MERL-Rose-Hulman/LilyBot-Raspberry-Pi/README.md

# LilyBot-Raspberry-Pi
LilyBot-Raspberry-Pi is a dedicated repository for the Raspberry Pi version of the Lilybot project. This repository includes specific code, 3D printed parts, electronic schematics, and detailed assembly instructions tailored for the Raspberry Pi controller.

use 3.3V sonar mounts for Grove system

gonna use grove system for wire connections, make the things easier.

Resberry pi OS will be use and all software will be installed from there as a package we can providiede.
