MERL-Rose-Hulman/LilyBot-Raspberry-Pi/3d_print_parts/Battery Mount/solidworks/Power Bank Holder.SLDPRT

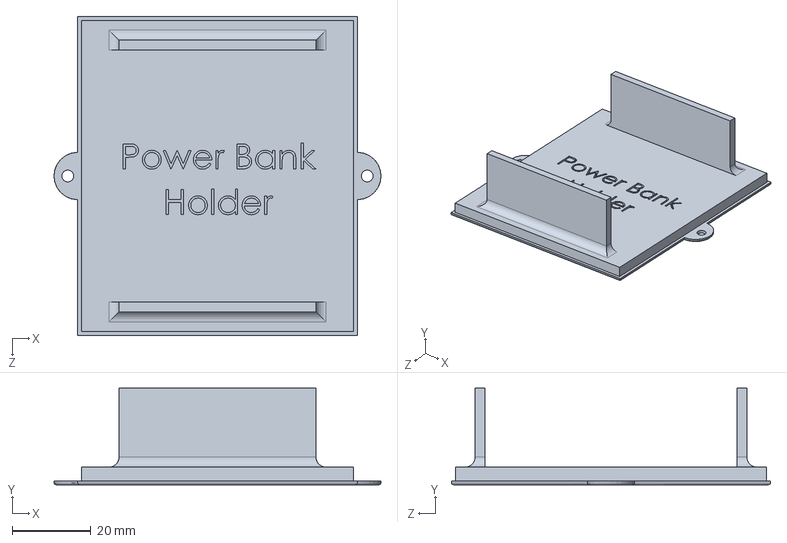
[picture p1: CAD file, 2024-08-13]
3d_print_parts/Battery Mount/solidworks/Power Bank Holder.SLDPRT
83.0 x 24.5 x 81.0 mm
