MERL-Rose-Hulman/LilyBot-Raspberry-Pi/3d_print_parts/Controller Mount/printer/Raspberry Pi_Module.3mf

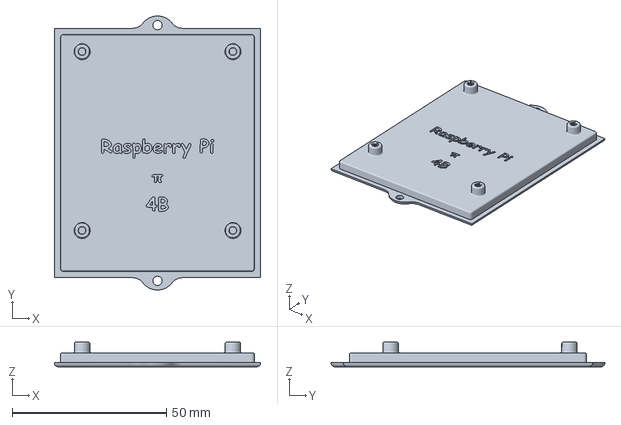
[picture p2: CAD file, 2025-09-22]
3d_print_parts/Controller Mount/printer/Raspberry Pi_Module.3mf
66.9 x 88.9 x 8.07 mm
