MERL-Rose-Hulman/LilyBot-Raspberry-Pi/LilyBotCommon/3D Print Parts/actuator/gripper/solidworks/Gripper attachment.SLDPRT

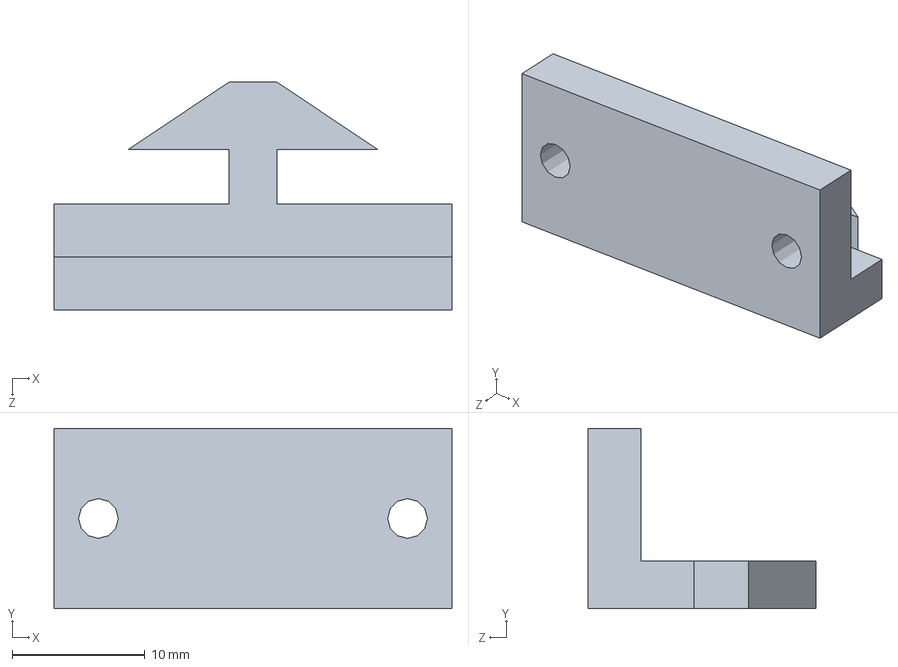
[picture p3: CAD file, 2024-08-06]
LilyBotCommon/3D Print Parts/actuator/gripper/solidworks/Gripper attachment.SLDPRT
30.0 x 13.6 x 17.2 mm
