MERL-Rose-Hulman/LilyBot-Raspberry-Pi/LilyBotCommon/3D Print Parts/actuator/gripper/stl/top-plate-fixed.stl

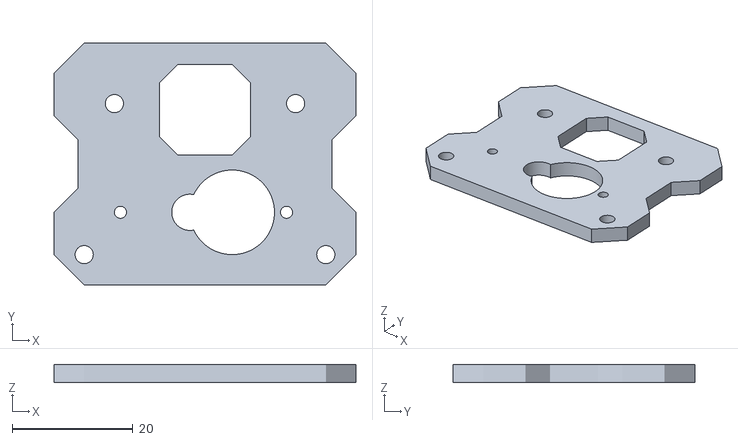
[picture p4: CAD file, 2024-08-06]
LilyBotCommon/3D Print Parts/actuator/gripper/stl/top-plate-fixed.stl
50.0 x 40.0 x 3.00
