MERL-Rose-Hulman/LilyBot-Raspberry-Pi/LilyBotCommon/3D Print Parts/chassis/bottom/solidworks/Lily Bottom Snap.SLDPRT

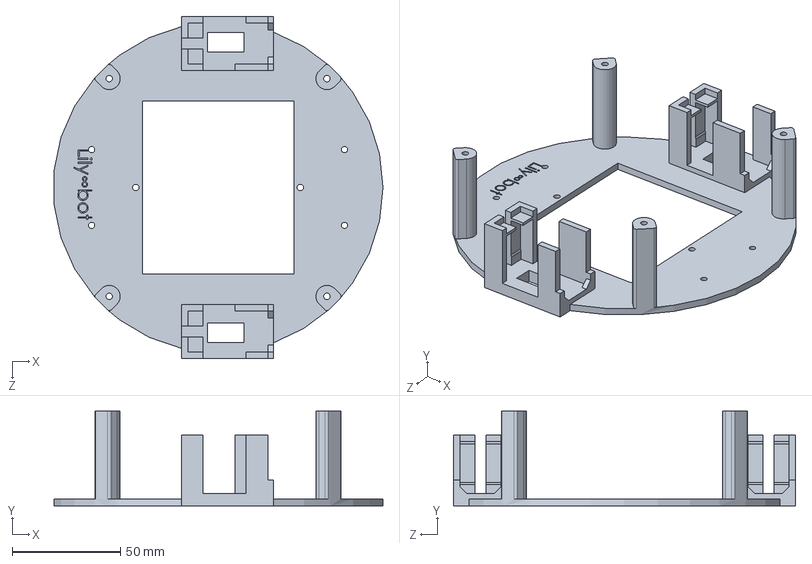
[picture p5: CAD file, 2024-08-06]
LilyBotCommon/3D Print Parts/chassis/bottom/solidworks/Lily Bottom Snap.SLDPRT
152.0 x 43.8 x 158.0 mm
