MERL-Rose-Hulman/LilyBot-Raspberry-Pi/LilyBotCommon/3D Print Parts/chassis/NOLONGERUSE/connection/solidworks/Lily standoffs.SLDPRT

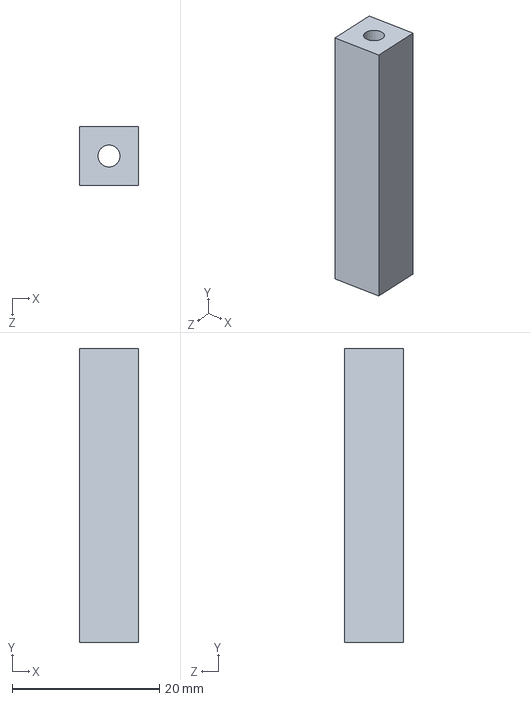
[picture p6: CAD file, 2024-08-06]
LilyBotCommon/3D Print Parts/chassis/NOLONGERUSE/connection/solidworks/Lily standoffs.SLDPRT
8.00 x 40.0 x 8.00 mm
