MERL-Rose-Hulman/LilyBot-Raspberry-Pi/LilyBotCommon/3D Print Parts/chassis/top/solidworks/Lily top Flex.SLDPRT

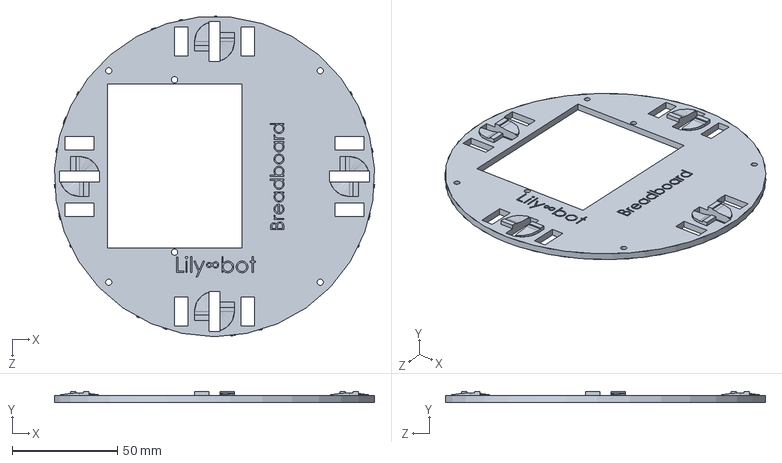
[picture p7: CAD file, 2024-08-06]
LilyBotCommon/3D Print Parts/chassis/top/solidworks/Lily top Flex.SLDPRT
152.2 x 5.08 x 152.4 mm
