MERL-Rose-Hulman/LilyBot-Raspberry-Pi/LilyBotCommon/3D Print Parts/cover/cover-higher-hight/solidworks/Lily Cover v2.SLDPRT

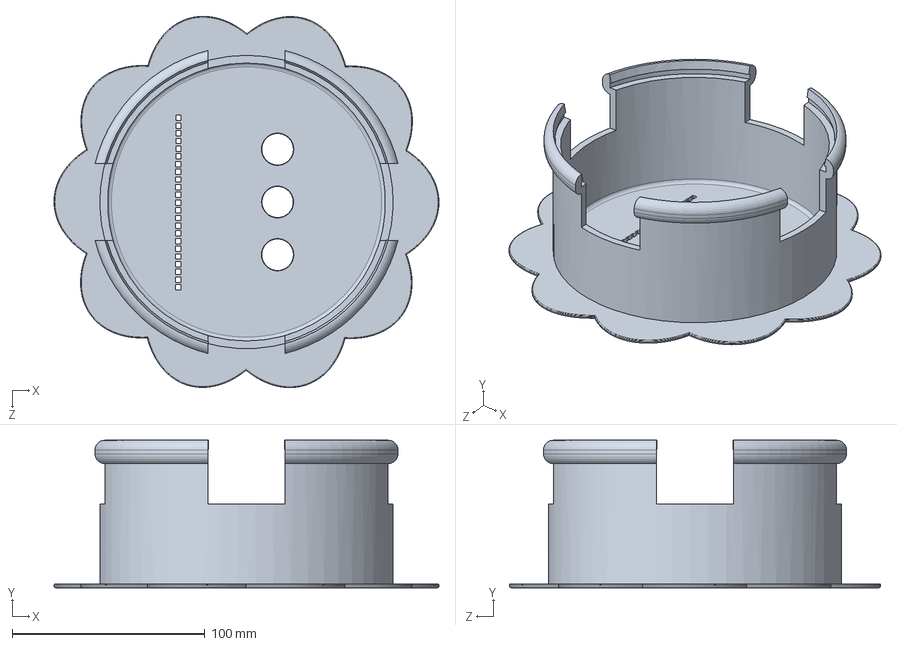
[picture p8: CAD file, 2024-08-06]
LilyBotCommon/3D Print Parts/cover/cover-higher-hight/solidworks/Lily Cover v2.SLDPRT
200.0 x 76.7 x 192.9 mm
