MERL-Rose-Hulman/LilyBot-Raspberry-Pi/LilyBotCommon/3D Print Parts/cover/cover-normal-hight/solidworks/Lily Cover.SLDPRT

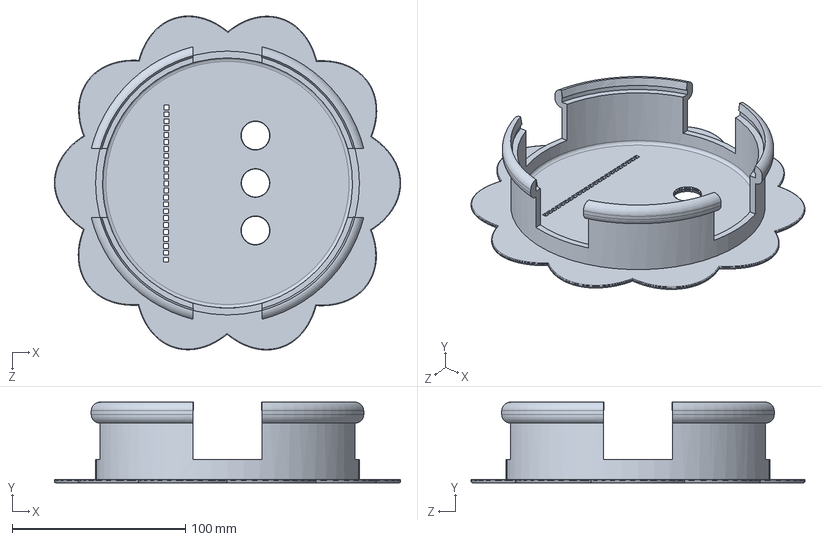
[picture p9: CAD file, 2024-08-06]
LilyBotCommon/3D Print Parts/cover/cover-normal-hight/solidworks/Lily Cover.SLDPRT
200.0 x 46.7 x 192.9 mm
