MERL-Rose-Hulman/LilyBot-Raspberry-Pi/LilyBotCommon/3D Print Parts/cover/NOLONGERUSED/cover tablets/solidworks/Lily Cover Hole Tablet Smaller.SLDPRT

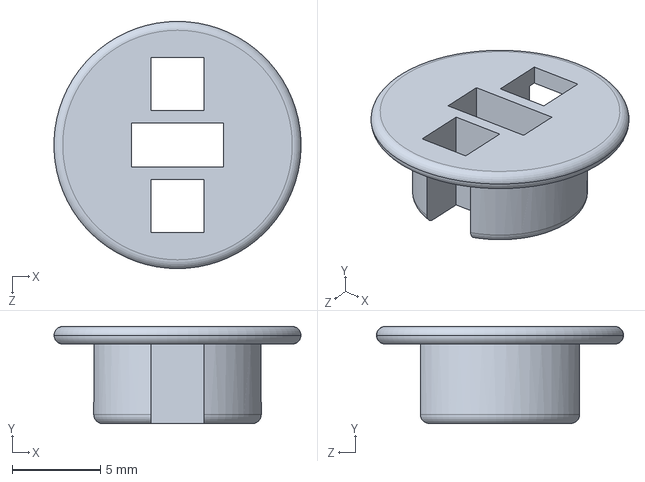
[picture p10: CAD file, 2024-08-06]
LilyBotCommon/3D Print Parts/cover/NOLONGERUSED/cover tablets/solidworks/Lily Cover Hole Tablet Smaller.SLDPRT
14.0 x 5.50 x 14.0 mm
