MERL-Rose-Hulman/LilyBot-Raspberry-Pi/LilyBotCommon/3D Print Parts/cover/NOLONGERUSED/cover v1/solidworks/Lily Cover.SLDPRT

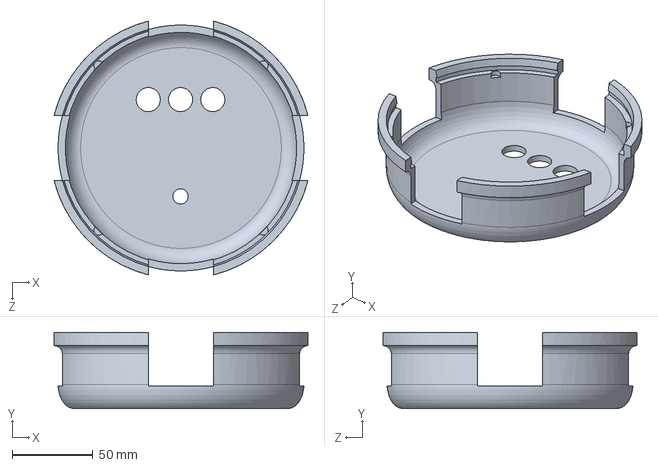
[picture p11: CAD file, 2024-08-06]
LilyBotCommon/3D Print Parts/cover/NOLONGERUSED/cover v1/solidworks/Lily Cover.SLDPRT
157.4 x 47.2 x 157.4 mm
