MERL-Rose-Hulman/LilyBot-Raspberry-Pi/LilyBotCommon/3D Print Parts/NOLONGERUSE/motor_mount/stl/Motor Mount Thick.STL

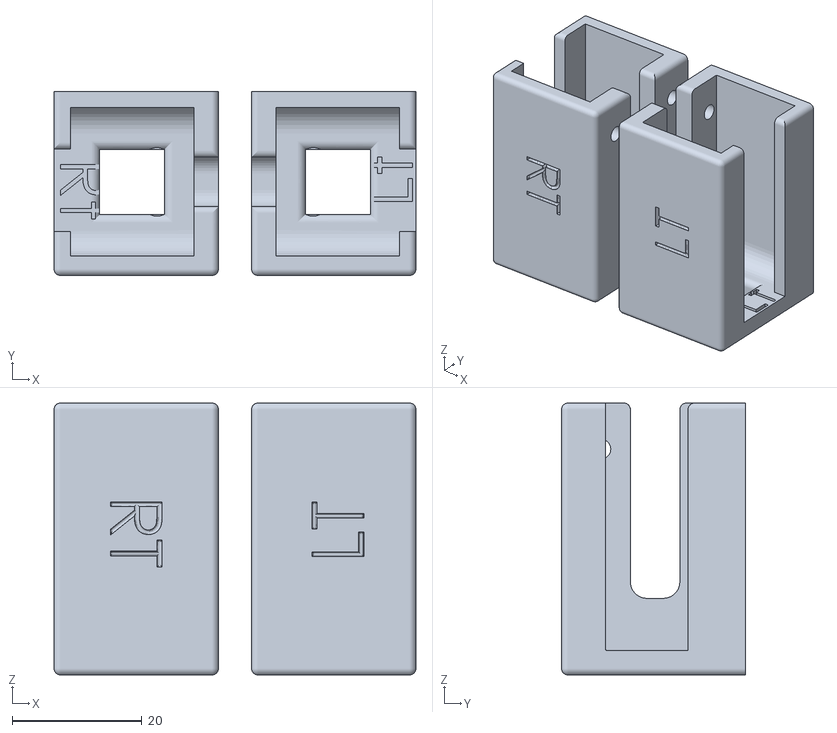
[picture p13: CAD file, 2024-08-06]
LilyBotCommon/3D Print Parts/NOLONGERUSE/motor_mount/stl/Motor Mount Thick.STL
55.8 x 28.4 x 41.9
