MERL-Rose-Hulman/LilyBot-Raspberry-Pi/LilyBotCommon/3D Print Parts/sensor_mount/IR/solidworks/IR sensor Attachment .SLDPRT

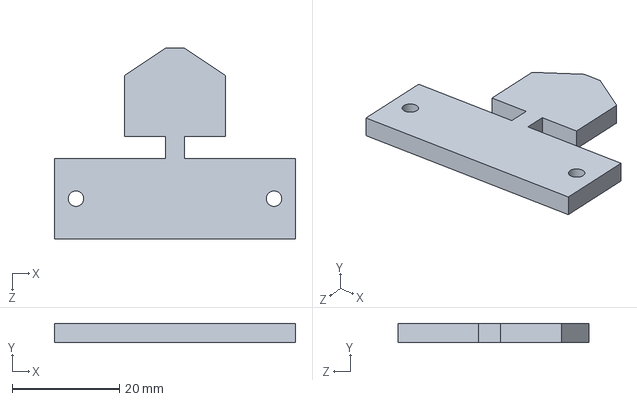
[picture p14: CAD file, 2024-08-06]
LilyBotCommon/3D Print Parts/sensor_mount/IR/solidworks/IR sensor Attachment .SLDPRT
45.0 x 3.58 x 35.6 mm
