MERL-Rose-Hulman/LilyBot-Raspberry-Pi/LilyBotCommon/3D Print Parts/sensor_mount/IR/stl/IR Attachment .STL

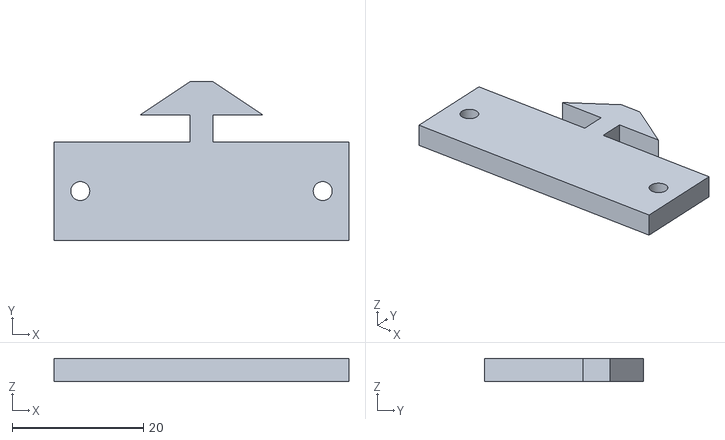
[picture p15: CAD file, 2024-08-06]
LilyBotCommon/3D Print Parts/sensor_mount/IR/stl/IR Attachment .STL
45.0 x 24.2 x 3.58
