MERL-Rose-Hulman/LilyBot-Raspberry-Pi/LilyBotCommon/3D Print Parts/sensor_mount/Sonar/solidworks/Sonar Attachment.SLDPRT

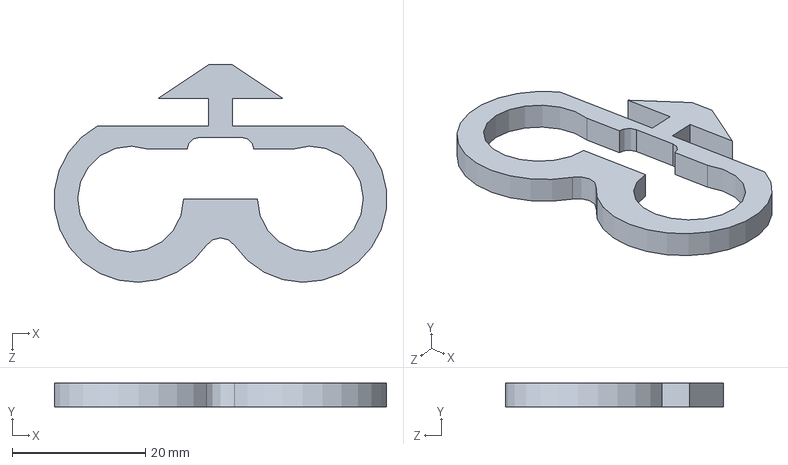
[picture p16: CAD file, 2024-08-06]
LilyBotCommon/3D Print Parts/sensor_mount/Sonar/solidworks/Sonar Attachment.SLDPRT
49.9 x 3.58 x 32.7 mm
