MERL-Rose-Hulman/LilyBot-Raspberry-Pi/LilyBotCommon/3D Print Parts/sensor_mount/ToF/solidworks/Tof sensor attachment.SLDPRT

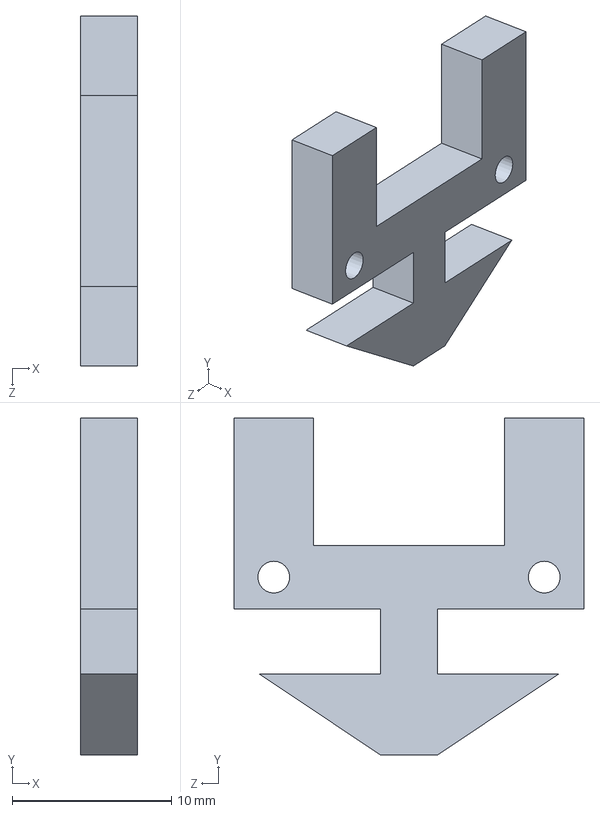
[picture p17: CAD file, 2024-08-06]
LilyBotCommon/3D Print Parts/sensor_mount/ToF/solidworks/Tof sensor attachment.SLDPRT
3.58 x 21.2 x 22.0 mm
