MERL-Rose-Hulman/LilyBot-Raspberry-Pi/LilyBotCommon/3D Print Parts/actuator/gripper/stl/servo-gear.stl

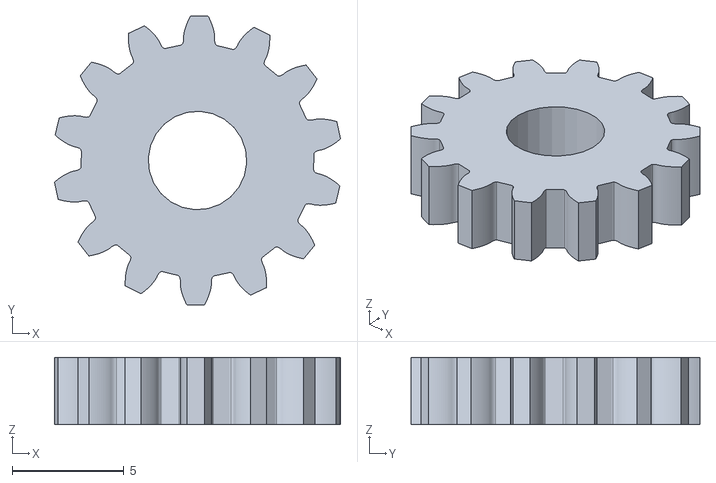
[picture p18: CAD file, 2024-08-06]
LilyBotCommon/3D Print Parts/actuator/gripper/stl/servo-gear.stl
12.8 x 12.9 x 3.00
