MERL-Rose-Hulman/LilyBot-Raspberry-Pi/LilyBotCommon/3D Print Parts/cover/NOLONGERUSED/cover tablets/solidworks/Lily Cover Hole Tablet.SLDPRT

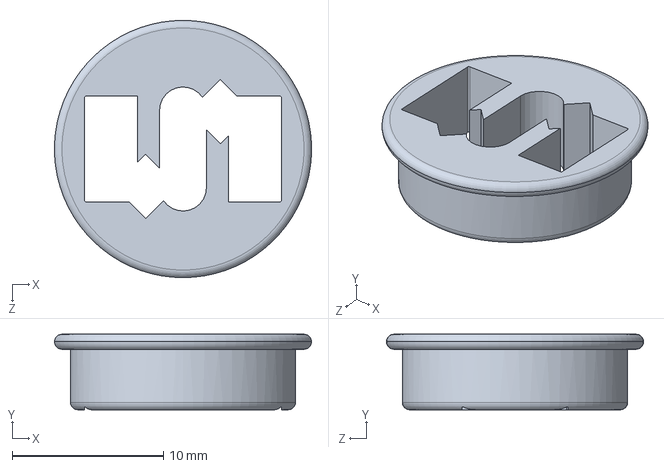
[picture p19: CAD file, 2024-08-06]
LilyBotCommon/3D Print Parts/cover/NOLONGERUSED/cover tablets/solidworks/Lily Cover Hole Tablet.SLDPRT
17.0 x 5.00 x 17.0 mm
