MERL-Rose-Hulman/LilyBot-Raspberry-Pi/LilyBotCommon/3D Print Parts/NOLONGERUSE/motor_mount/solidworks/Motor Mount.SLDPRT

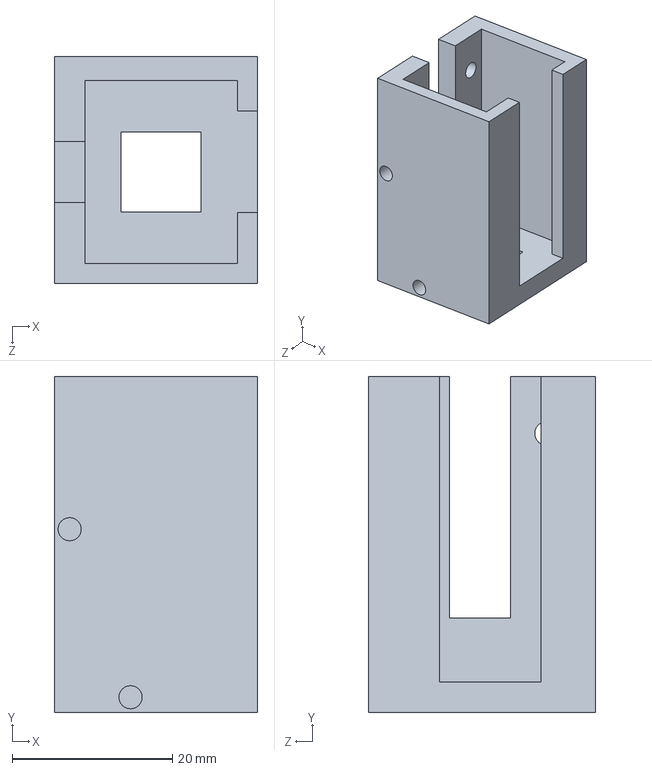
[picture p20: CAD file, 2024-08-06]
LilyBotCommon/3D Print Parts/NOLONGERUSE/motor_mount/solidworks/Motor Mount.SLDPRT
25.4 x 41.9 x 28.4 mm
