MERL-Rose-Hulman/LilyBot-Raspberry-Pi/LilyBotCommon/3D Print Parts/sensor_mount/Sonar/solidworks/Sonar_3V Attachment.SLDPRT

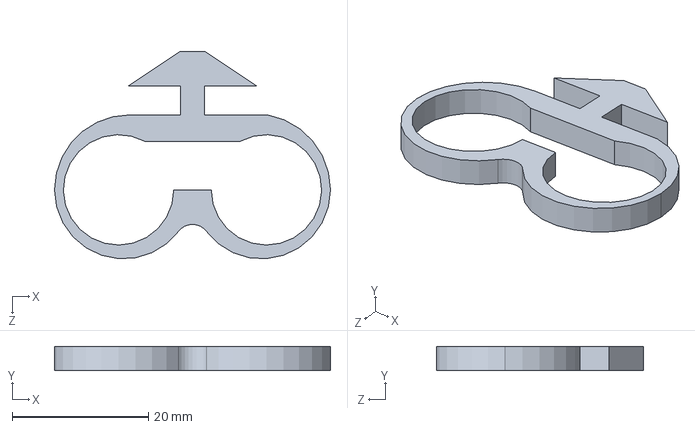
[picture p21: CAD file, 2024-08-06]
LilyBotCommon/3D Print Parts/sensor_mount/Sonar/solidworks/Sonar_3V Attachment.SLDPRT
40.5 x 3.58 x 30.4 mm
