MERL-Rose-Hulman/LilyBot-Raspberry-Pi/LilyBotCommon/3D Print Parts/actuator/gripper/stl/finger-right-thin.stl

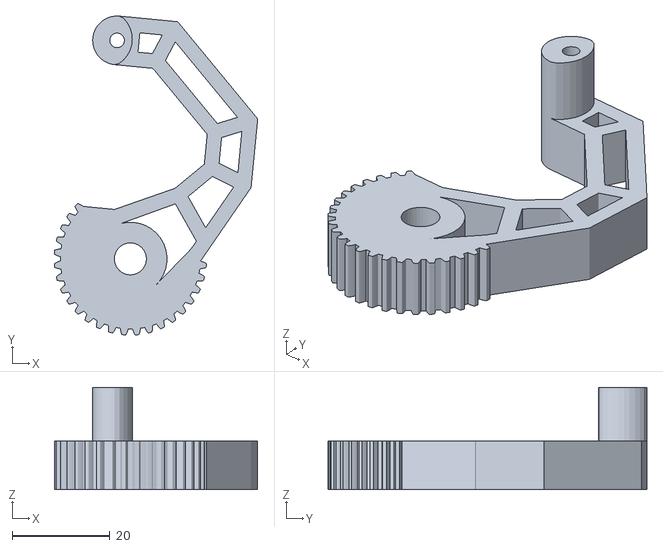
[picture p22: CAD file, 2024-08-06]
LilyBotCommon/3D Print Parts/actuator/gripper/stl/finger-right-thin.stl
41.7 x 65.4 x 21.0
