MERL-Rose-Hulman/LilyBot-Raspberry-Pi/LilyBotCommon/3D Print Parts/sensor_mount/IR/solidworks/IR sensor Attachment Short.SLDPRT

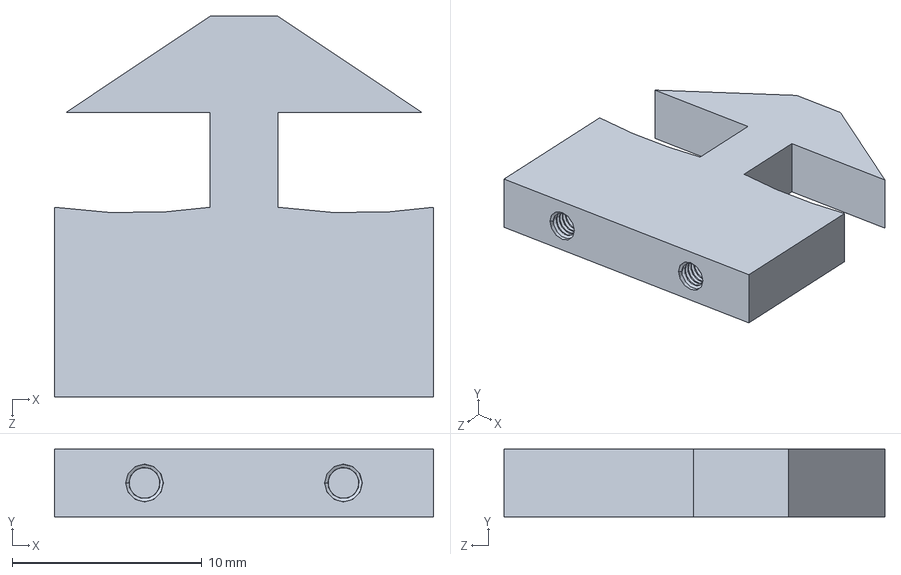
[picture p23: CAD file, 2024-08-06]
LilyBotCommon/3D Print Parts/sensor_mount/IR/solidworks/IR sensor Attachment Short.SLDPRT
20.0 x 3.58 x 20.1 mm
