MERL-Rose-Hulman/LilyBot-Raspberry-Pi/LilyBotCommon/3D Print Parts/actuator/gripper/stl/gripper-base-thin.stl

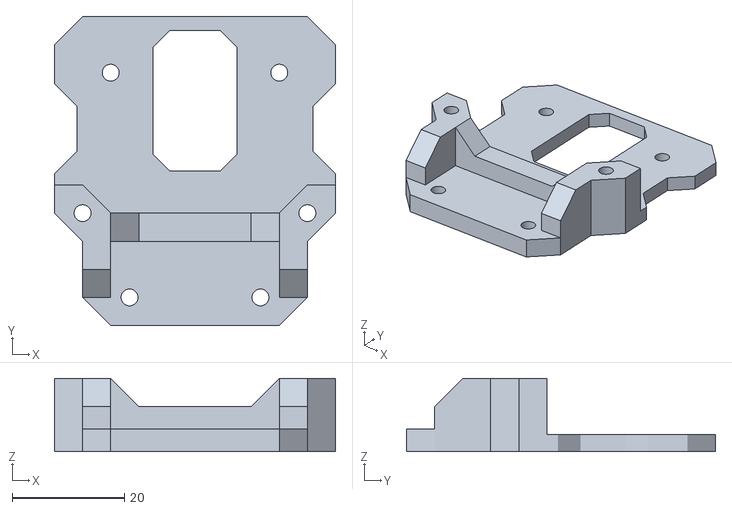
[picture p24: CAD file, 2024-08-06]
LilyBotCommon/3D Print Parts/actuator/gripper/stl/gripper-base-thin.stl
50.0 x 55.0 x 13.0
