MERL-Rose-Hulman/LilyBot-Raspberry-Pi/LilyBotCommon/3D Print Parts/actuator/gripper/stl/finger-pad.stl

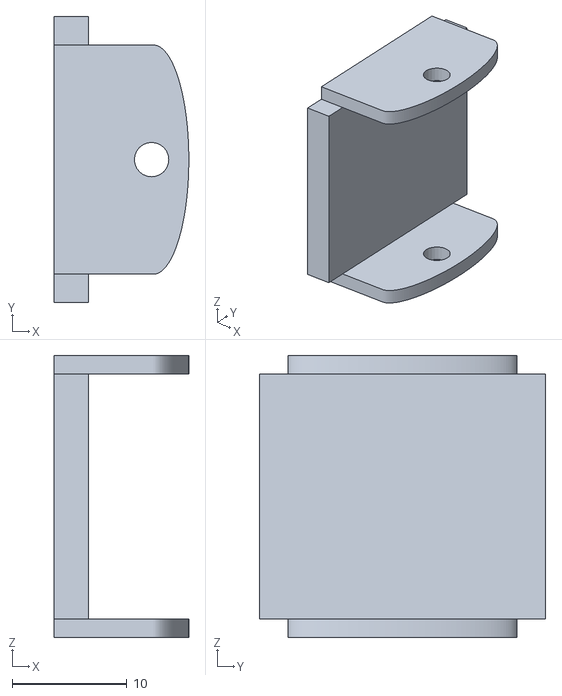
[picture p25: CAD file, 2024-08-06]
LilyBotCommon/3D Print Parts/actuator/gripper/stl/finger-pad.stl
11.8 x 25.0 x 24.6
