MERL-Rose-Hulman/LilyBot-Raspberry-Pi/LilyBotCommon/3D Print Parts/actuator/gripper/stl/finger-bushing-thin.stl

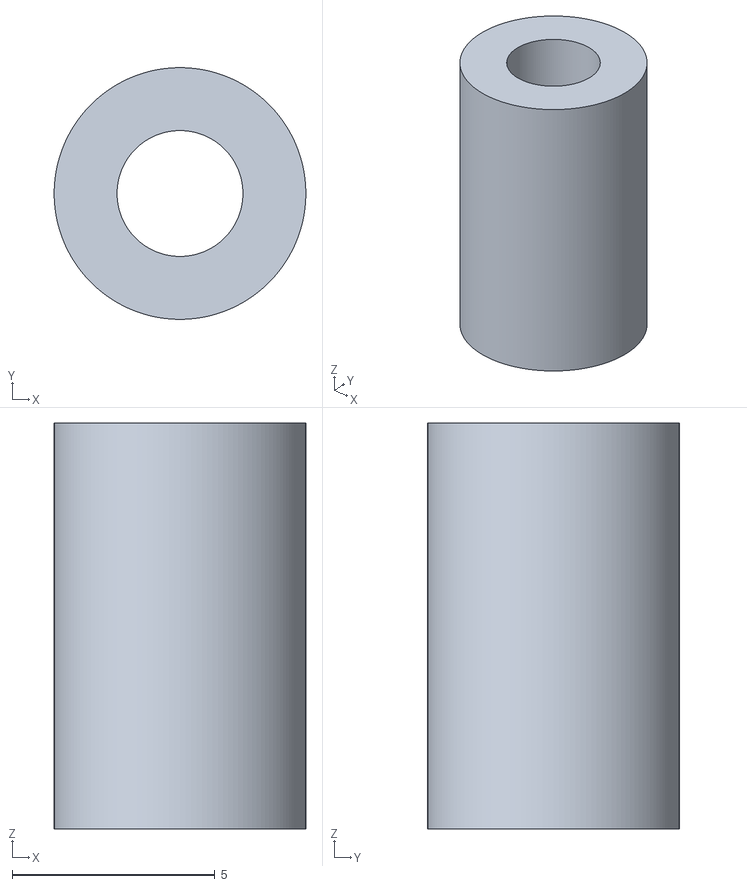
[picture p26: CAD file, 2024-08-06]
LilyBotCommon/3D Print Parts/actuator/gripper/stl/finger-bushing-thin.stl
6.20 x 6.20 x 10.0
