MERL-Rose-Hulman/LilyBot-Raspberry-Pi/LilyBotCommon/3D Print Parts/actuator/gripper/stl/finger-left-thin.stl

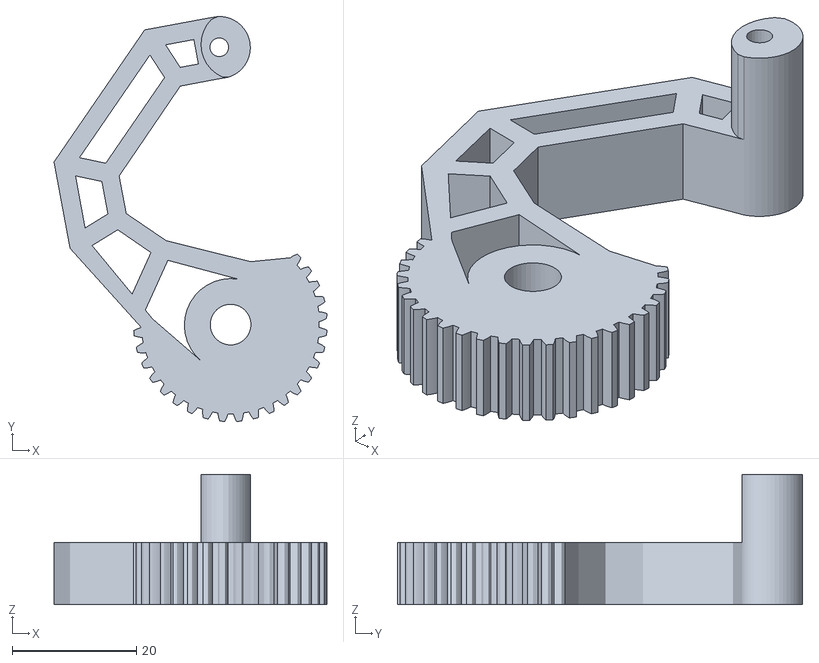
[picture p27: CAD file, 2024-08-06]
LilyBotCommon/3D Print Parts/actuator/gripper/stl/finger-left-thin.stl
44.0 x 65.2 x 21.0
