MERL-Rose-Hulman/LilyBot-Raspberry-Pi/LilyBotCommon/3D Print Parts/actuator/gripper/stl/servo-spacer-bigger.stl

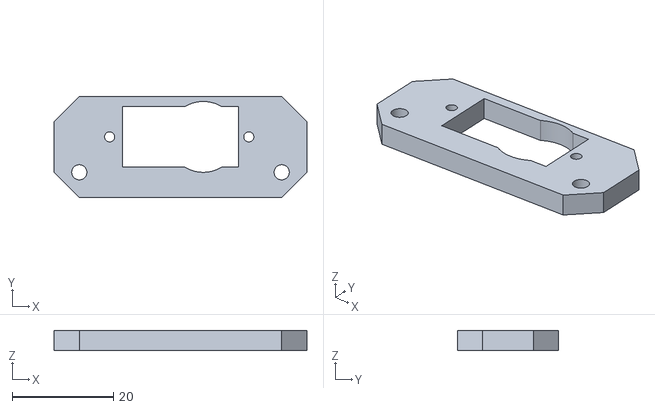
[picture p28: CAD file, 2024-08-06]
LilyBotCommon/3D Print Parts/actuator/gripper/stl/servo-spacer-bigger.stl
50.0 x 20.0 x 4.00
