MERL-Rose-Hulman/LilyBot-Raspberry-Pi/(list of files, cad)

Other CAD files:
3d_print_parts/Controller Mount/solidworks/Raspberry Pi_Module.SLDPRT
LilyBotCommon/3D Print Parts/chassis/top/stl/Lily top.STL
LilyBotCommon/3D Print Parts/NOLONGERUSE/motor_mount/stl/Motor Mount Thin.STL
LilyBotCommon/3D Print Parts/sensor_mount/IR/solidworks/IR sensor Attachment - Long.SLDPRT
3d_print_parts/Battery Mount/stl/Power Bank Holder.STL
3d_print_parts/Controller Mount/stl/Raspberry Pi_Module.STL
LilyBotCommon/3D Print Parts/actuator/gripper/stl/GripperAttachment.STL
LilyBotCommon/3D Print Parts/chassis/NOLONGERUSE/connection/stl/Lily standoffs.STL
LilyBotCommon/3D Print Parts/chassis/NOLONGERUSE/lower/solidworks/Lily Bottom Cutout (old).SLDPRT
LilyBotCommon/3D Print Parts/chassis/NOLONGERUSE/lower/stl/Lily Bottom Cutted for Motor (old).STL
LilyBotCommon/3D Print Parts/chassis/NOLONGERUSE/lower/stl/Lily Bottom Flex (old).STL
LilyBotCommon/3D Print Parts/chassis/bottom/stl/Lily Bottom Snap.STL
LilyBotCommon/3D Print Parts/cover/NOLONGERUSED/cover tablets/stl/Lily Cover Hole Tablet Smaller.STL
LilyBotCommon/3D Print Parts/cover/NOLONGERUSED/cover tablets/stl/Lily Cover Hole Tablet.STL
LilyBotCommon/3D Print Parts/cover/NOLONGERUSED/cover v1/stl/Lily Cover.STL
LilyBotCommon/3D Print Parts/cover/cover-normal-hight/stl/Lily Cover.STL
LilyBotCommon/3D Print Parts/sensor_mount/IR/stl/IR sensor Attachment Short.STL
LilyBotCommon/3D Print Parts/sensor_mount/Sonar/stl/Sonar Attachment .STL
LilyBotCommon/3D Print Parts/sensor_mount/Sonar/stl/Sonar_3V Attachment.STL
LilyBotCommon/3D Print Parts/sensor_mount/ToF/stl/Tof sensor attachment.STL
