MERL-Rose-Hulman/LilyBot-Raspberry-Pi/code/Python/lilybot/peripherals/ultrasonic.py

#!/usr/bin/env python
#
# This is the code for Grove - Ultrasonic Ranger
# (https://www.seeedstudio.com/Grove-Ultrasonic-Ranger-p-960.html)
# which is a non-contact distance measurement module which works with 40KHz sound wave. 
#
# This is the library for Grove Base Hat which used to connect grove sensors for raspberry pi.
#

'''
## License

The MIT License (MIT)

Grove Base Hat for the Raspberry Pi, used to connect grove sensors.
Copyright (C) 2018  Seeed Technology Co.,Ltd. 

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
THE SOFTWARE IS PROVIDED "AS IS", WITHOUT WARRANTY OF ANY KIND, EXPRESS OR
IMPLIED, INCLUDING BUT NOT LIMITED TO THE WARRANTIES OF MERCHANTABILITY,
FITNESS FOR A PARTICULAR PURPOSE AND NONINFRINGEMENT. IN NO EVENT SHALL THE
AUTHORS OR COPYRIGHT HOLDERS BE LIABLE FOR ANY CLAIM, DAMAGES OR OTHER
LIABILITY, WHETHER IN AN ACTION OF CONTRACT, TORT OR OTHERWISE, ARISING FROM,
OUT OF OR IN CONNECTION WITH THE SOFTWARE OR THE USE OR OTHER DEALINGS IN
THE SOFTWARE.
'''
import sys
import time
from typing import Optional

try:
    from grove.gpio import GPIO
except ImportError:  # pragma: no cover - allow import on dev machines
    GPIO = None  # type: ignore[assignment]

usleep = lambda x: time.sleep(x / 1000000.0)

_TIMEOUT1 = 1000
_TIMEOUT2 = 10000

class GroveUltrasonicRanger(object):
    def __init__(self, pin: Optional[int] = None, *, gpio: Optional[GPIO] = None):
        if gpio is None:
            if GPIO is None:
                raise RuntimeError(
                    "grove.gpio module not available. Install grove libraries on Raspberry Pi."
                )
            if pin is None:
                raise ValueError("pin must be provided when gpio is None")
            self.dio = GPIO(pin)
        else:
            self.dio = gpio
        self.pin = pin if pin is not None else getattr(self.dio, "pin", None)

    def _get_distance(self):
        self.dio.dir(GPIO.OUT)
        self.dio.write(0)
        usleep(2)
        self.dio.write(1)
        usleep(10)
        self.dio.write(0)

        self.dio.dir(GPIO.IN)

        t0 = time.time()
        count = 0
        while count < _TIMEOUT1:
            if self.dio.read():
                break
            count += 1
        if count >= _TIMEOUT1:
            return None

        t1 = time.time()
        count = 0
        while count < _TIMEOUT2:
            if not self.dio.read():
                break
            count += 1
        if count >= _TIMEOUT2:
            return None

        t2 = time.time()

        dt = int((t1 - t0) * 1000000)
        if dt > 530:
            return None

        distance = ((t2 - t1) * 1000000 / 29 / 2)    # cm

        return distance

    def get_distance(self):
        while True:
            dist = self._get_distance()
            if dist:
                return dist


Grove = GroveUltrasonicRanger


def main():
    from grove.helper import SlotHelper
    sh = SlotHelper(SlotHelper.GPIO)
    pin = sh.argv2pin()

    sonar = GroveUltrasonicRanger(pin)

    print('Detecting distance...')
    while True:
        print('{} cm'.format(sonar.get_distance()))
        time.sleep(1)

if __name__ == '__main__':
    main()
