MERL-Rose-Hulman/LilyBot-Raspberry-Pi/(commit log)

2024-08-06 Basic Setup for π
    [9V Battery Holder New.SLDPRT, 9V Battery Holder.STL, Gripper attachment.SLDPRT, GripperAttachment.STL, IR Attachment .STL, IR sensor Attachment - Long.SLDPRT, IR sensor Attachment .SLDPRT, IR sensor Attachment Short.SLDPRT]
2024-08-07 π Mount
    [Raspberry Pi_Module.SLDPRT, Raspberry Pi_Module.STL, Uno_Module.SLDPRT, Uno_Module.STL]
2024-08-13 Power Bank Holder
    [9V Battery Holder New.SLDPRT, 9V Battery Holder.STL, Power Bank Holder.SLDPRT, Power Bank Holder.STL]
2025-10-14 fix Ultrasonic
2025-10-16 modified i2C
